dirksan28/Scenic2DashCanEmu/pics/inUseOnDesk.jpg

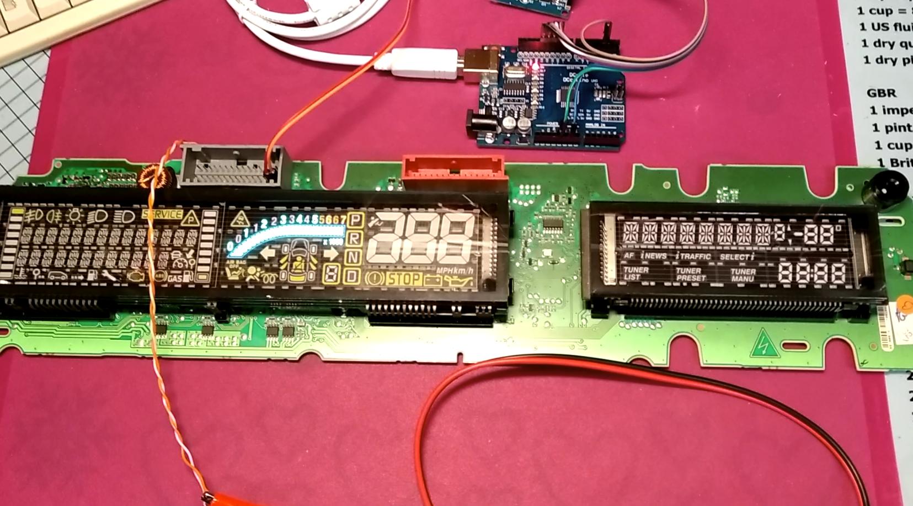
pics/inUseOnDesk.jpg
