dirksan28/Scenic2DashCanEmu/pics/vidThumb.jpg

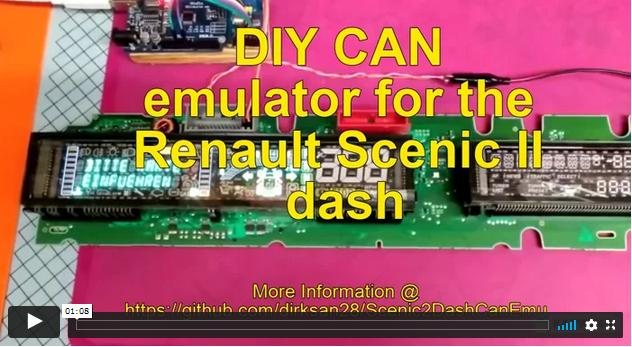
pics/vidThumb.jpg
