dirksan28/Scenic2DashCanEmu/pics/Scenic2SteeringWheelRadioRemote.pdf

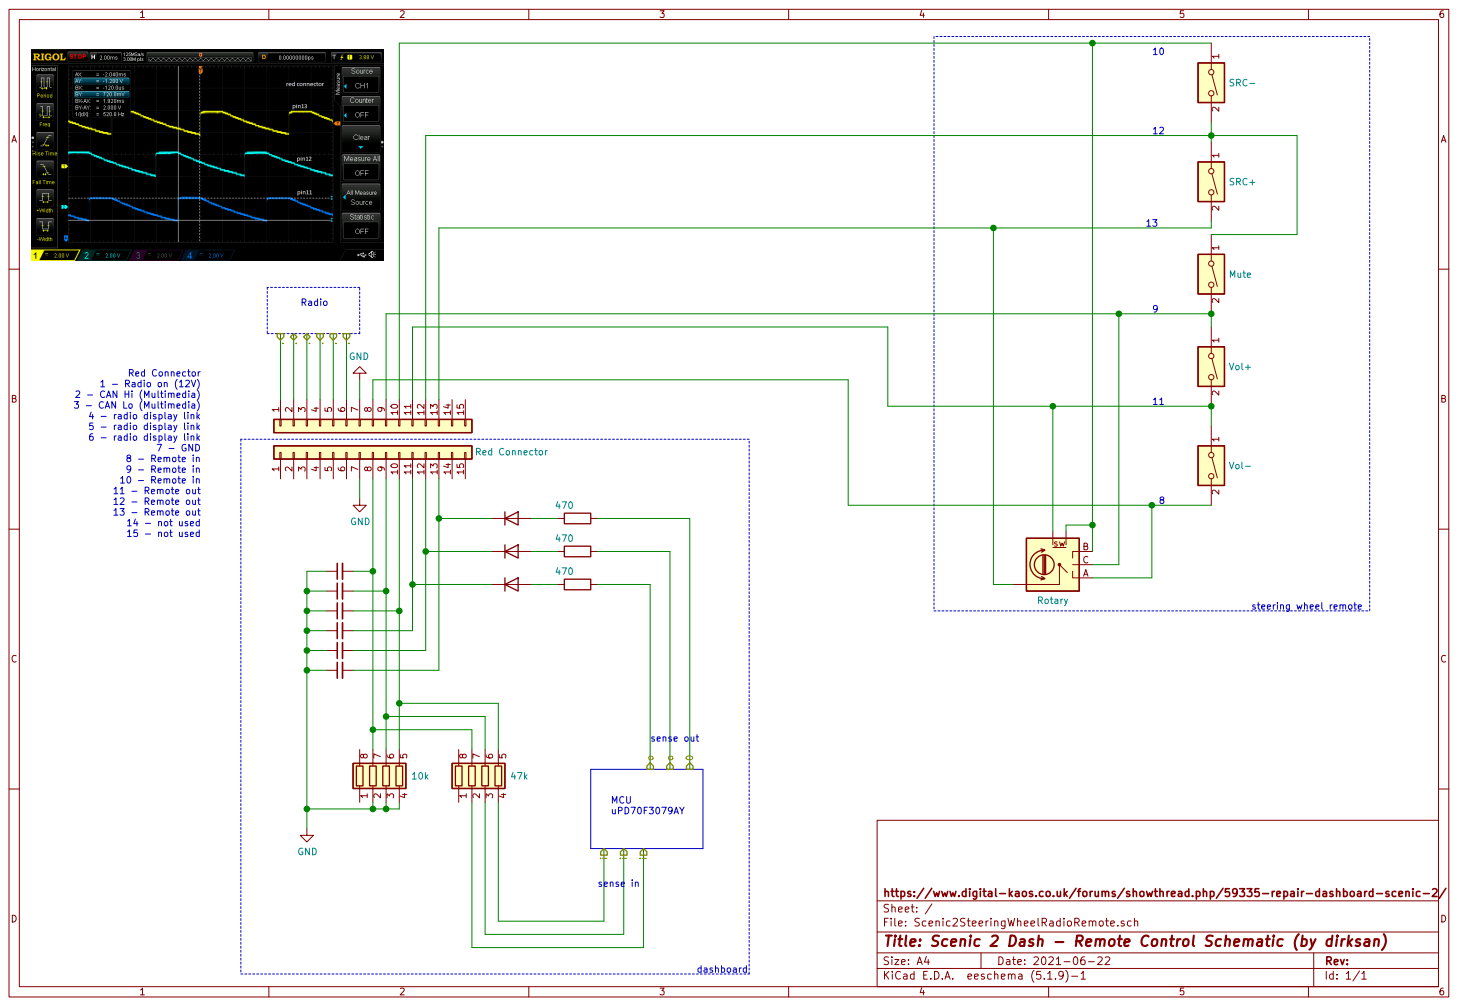
[picture p7: page 1]

Red Connector 1 - Radio on (12V)

2 - CAN Hi (Multimedia)
3 - CAN Lo (Multimedia)
4 - radio display link
5 - radio display link
6 - radio display link 7 - GND

8 - Remote in
9 - Remote in
10 - Remote in
11 - Remote out 12 - Remote out 13 - Remote out 14 - not used

File: Scenic2SteeringWheelRadioRemote.sch Sheet: / https://www.digital-kaos.co.uk/forums/showthread.php/59335-repair-dashboard-scenic-2/ 1

Id: 1/1 Title: Scenic 2 Dash - Remote Control Schematic (by dirksan)
