dirksan28/Scenic2DashCanEmu/(threads)

Thread 2 (2024-07-08):

CAN_INT_PIN unused?

petrol-engine, 2024-07-08:
I see the INT definition...

#define CAN_INT_PIN 2

but it is **not** used in any project file nor in the SPI library (?)

dirksan28, 2025-01-11:
Has been fixed in https://github.com/dirksan28/Scenic2DashCanEmu/commit/7f710a83ce7bf32f8ec76c5ade55d8985a7ff16d

Thank you.

Closed 2025-01-11.
