dirksan28/Scenic2DashCanEmu/(commit log)

2021-04-29 Create Arduino
2024-01-10 Update README.md
    Hint for power-up without a can emu.
2024-06-22 spelling, power supply hint, mac-OS
2025-01-11 Update canEmulator.ino
    fixed spelling and formating
    [canEmulator.ino]
